range-robot/perimeter_wire/firmware/dfp/Readme.md

This folder contains device family packs (DFP)
Downloaded from: http://packs.download.atmel.com/

See https://www.microchip.com/mplab/avr-support/avr-and-arm-toolchains-c-compilers for how to use DFP
