range-robot/perimeter_wire/firmware/sensor/Readme.md

# Perimeter wire sensor firmware

## ADC

* Max Freq: 2100MHz
* Periperial Freq: 24.005MHz
* Div: 128
* Freq: 187.539kHz
* Clocks per Sample: 7
* Sampling rate: 26791Hz

* Max Freq: 2100MHz
* Periperial Freq: 24.005MHz
* Div: 16
* Freq: 1500.3kHz
* Clocks per Sample: 7
* Sampling rate: 214330Hz
