range-robot/perimeter_wire/pcb/sensor/ltspice/ti.png

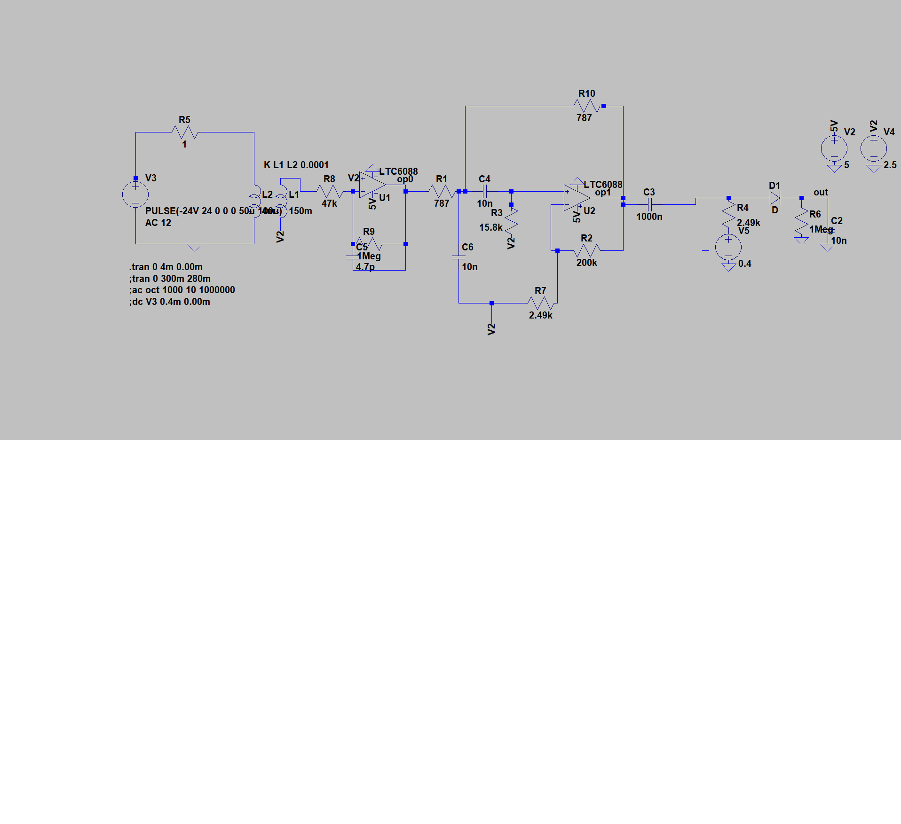
pcb/sensor/ltspice/ti.png
