range-robot/perimeter_wire/driver/generator/CHANGELOG.rst

^^^^^^^^^^^^^^^^^^^^^^^^^^^^^^^^^^^^^^^^^^^^^^^^^^^^^
Changelog for package perimeter_wire_generator_driver
^^^^^^^^^^^^^^^^^^^^^^^^^^^^^^^^^^^^^^^^^^^^^^^^^^^^^

0.0.3 (2020-06-30)
------------------

0.0.2 (2020-05-10)
------------------

0.0.1 (2020-04-14)
------------------
* Initial generator driver
* Contributors: Michael Stoll
