range-robot/perimeter_wire/driver/sensor/CHANGELOG.rst

^^^^^^^^^^^^^^^^^^^^^^^^^^^^^^^^^^^^^^^^^^^^^^^^^^
Changelog for package perimeter_wire_sensor_driver
^^^^^^^^^^^^^^^^^^^^^^^^^^^^^^^^^^^^^^^^^^^^^^^^^^

0.0.3 (2020-06-30)
------------------
* Log info about orientation
* Contributors: Michael Stoll

0.0.2 (2020-05-10)
------------------
* Add orientation parameter
* Add information about code weight to console
* Contributors: Michael Stoll

0.0.1 (2020-04-14)
------------------
* Initial sensor driver
* Contributors: Michael Stoll
