range-robot/perimeter_wire/firmware/sensor/CHANGELOG.rst

^^^^^^^^^^^^^^^^^^^^^^^^^^^^^^^^^^^^^^^^^^^^^^^^^^^^
Changelog for package perimeter_wire_sensor_firmware
^^^^^^^^^^^^^^^^^^^^^^^^^^^^^^^^^^^^^^^^^^^^^^^^^^^^

0.0.3 (2020-06-30)
------------------

0.0.2 (2020-05-10)
------------------
* add doc and script for testing
* Contributors: Michael Stoll

0.0.1 (2020-04-14)
------------------
* Initial sensor firmware
* Contributors: Michael Stoll
