range-robot/perimeter_wire/pcb/sensor/ltspice/pw_my.asc

C1: cap; 1p
C2: cap; 10n
C3: cap; 10n
D1: diode
L1: ind; 85m
R1: res; 82k
R2: res; 220k
R4: res; 220k
R5: res; 22k
R6: res; 1Meg
U1: LTC6088
U2: LTC6088
V1: voltage; PWL(0.049m 0 0.05m 80m 0.051m 0 0.099m 0 0.1m -80m 0.101m 0 0.149m 0 0.15m 80m 0.151m 0 0.199m 0 0.20m -80m 0.201m 0 0.249m 0 0.25m 80m 0.251m 0 0.299m 0 0.3m -80m 0.301m 0); AC 80m
V2: voltage; 5
V3: voltage; SINE(0 80mV 10000)
V4: voltage; 0.8
Named nets: in, filter, op1, 0, 5V, V2, op2, out
.tran 0 0.4m 0.00m
;tran 0 30m 0.00m
;ac oct 1000 10 100000
