range-robot/perimeter_wire/pcb/sensor/ltspice/pw_original.asc

C1: cap; 47p
C2: cap; 100n
C3: cap; 1000n
C4: cap; 47p
C5: cap; 1000n
D1: diode; 1N4148
D2: diode; 1N4148
L1: ind2; 85m
L2: ind2; 1m
R1: res; 85k
R2: res; 100k
R3: res; 10k
R4: res; 100k
R5: res; 10k
R6: res; 10Meg
R7: res; 100k
R8: res; 10
R9: res; 10Meg
R10: res; 10k
U1: LTC6088
U2: LTC6088
V1: voltage; PULSE(-24V 24V 0 0 0 1m 2m); AC 80m
V2: voltage; 5
V4: voltage; 1.5
Named nets: filter, op1, 0, 5V, V2, op2, out
.tran 0 2000m 0.00m
;.ac oct 1000 100 100000
K L1 L2 0.00001
