range-robot/perimeter_wire/pcb/sensor/ltspice/pw_ti.asc

C2: cap; 10n
C3: cap; 1000n
C4: cap; 10n
C5: cap; 4.7p
C6: cap; 10n
D1: diode
L1: ind2; 150m
L2: ind2; 4m
R1: res; 787
R2: res; 200k
R3: res; 15.8k
R4: res; 2.49k
R5: res; 1
R6: res; 1Meg
R7: res; 2.49k
R8: res; 47k
R9: res; 1Meg
R10: res; 787
U1: LTC6088
U2: LTC6088
V2: voltage; 5
V3: voltage; PULSE(-24V 24 0 0 0 50u 100u); AC 12
V4: voltage; 2.5
V5: voltage; 0.4
Named nets: op1, 0, 5V, V2, out, op0
.tran 0 4m 0.00m
;tran 0 300m 280m
;ac oct 1000 10 1000000
;dc V3 0.4m 0.00m
K L1 L2 0.0001
