range-robot/perimeter_wire/firmware/generator/driver_init.c

/*
 * Code generated from Atmel Start.
 *
 * This file will be overwritten when reconfiguring your Atmel Start project.
 * Please copy examples or other code you want to keep to a separate file
 * to avoid losing it when reconfiguring.
 */

#include "driver_init.h"
#include <peripheral_clk_config.h>
#include <utils.h>
#include <hal_init.h>
#include <hpl_gclk_base.h>
#include <hpl_pm_base.h>

#include <hpl_adc_base.h>

/* The channel amount for ADC */
#define ADC_0_CH_AMOUNT 1

/* The buffer size for ADC */
#define ADC_0_BUFFER_SIZE 16

/* The maximal channel number of enabled channels */
#define ADC_0_CH_MAX 0

struct adc_async_descriptor         ADC_0;
struct adc_async_channel_descriptor ADC_0_ch[ADC_0_CH_AMOUNT];
struct timer_descriptor             TIMER_0;

static uint8_t ADC_0_buffer[ADC_0_BUFFER_SIZE];
static uint8_t ADC_0_map[ADC_0_CH_MAX + 1];

struct flash_descriptor FLASH_INSTANCE;

/**
 * \brief ADC initialization function
 *
 * Enables ADC peripheral, clocks and initializes ADC driver
 */
void ADC_0_init(void)
{
	_pm_enable_bus_clock(PM_BUS_APBC, ADC);
	_gclk_enable_channel(ADC_GCLK_ID, CONF_GCLK_ADC_SRC);
	adc_async_init(&ADC_0, ADC, ADC_0_map, ADC_0_CH_MAX, ADC_0_CH_AMOUNT, &ADC_0_ch[0], (void *)NULL);
	adc_async_register_channel_buffer(&ADC_0, 0, ADC_0_buffer, ADC_0_BUFFER_SIZE);

	// Disable digital pin circuitry
	gpio_set_pin_direction(V_SENSE, GPIO_DIRECTION_OFF);

	gpio_set_pin_function(V_SENSE, PINMUX_PA04B_ADC_AIN4);

	// Disable digital pin circuitry
	gpio_set_pin_direction(R_TEMP, GPIO_DIRECTION_OFF);

	gpio_set_pin_function(R_TEMP, PINMUX_PA05B_ADC_AIN5);
}

void FLASH_INSTANCE_CLOCK_init(void)
{

	_pm_enable_bus_clock(PM_BUS_APBB, NVMCTRL);
}

void FLASH_INSTANCE_init(void)
{
	FLASH_INSTANCE_CLOCK_init();
	flash_init(&FLASH_INSTANCE, NVMCTRL);
}

/**
 * \brief Timer initialization function
 *
 * Enables Timer peripheral, clocks and initializes Timer driver
 */
static void TIMER_0_init(void)
{
	_pm_enable_bus_clock(PM_BUS_APBC, TC3);
	_gclk_enable_channel(TC3_GCLK_ID, CONF_GCLK_TC3_SRC);

	timer_init(&TIMER_0, TC3, _tc_get_timer());
}

void USB_DEVICE_INSTANCE_PORT_init(void)
{

	gpio_set_pin_direction(USB_DM,
	                       // <y> Pin direction
	                       // <id> pad_direction
	                       // <GPIO_DIRECTION_OFF"> Off
	                       // <GPIO_DIRECTION_IN"> In
	                       // <GPIO_DIRECTION_OUT"> Out
	                       GPIO_DIRECTION_OUT);

	gpio_set_pin_level(USB_DM,
	                   // <y> Initial level
	                   // <id> pad_initial_level
	                   // <false"> Low
	                   // <true"> High
	                   false);

	gpio_set_pin_pull_mode(USB_DM,
	                       // <y> Pull configuration
	                       // <id> pad_pull_config
	                       // <GPIO_PULL_OFF"> Off
	                       // <GPIO_PULL_UP"> Pull-up
	                       // <GPIO_PULL_DOWN"> Pull-down
	                       GPIO_PULL_OFF);

	gpio_set_pin_function(USB_DM,
	                      // <y> Pin function
	                      // <id> pad_function
	                      // <i> Auto : use driver pinmux if signal is imported by driver, else turn off function
	                      // <PINMUX_PA24G_USB_DM"> Auto
	                      // <GPIO_PIN_FUNCTION_OFF"> Off
	                      // <GPIO_PIN_FUNCTION_A"> A
	                      // <GPIO_PIN_FUNCTION_B"> B
	                      // <GPIO_PIN_FUNCTION_C"> C
	                      // <GPIO_PIN_FUNCTION_D"> D
	                      // <GPIO_PIN_FUNCTION_E"> E
	                      // <GPIO_PIN_FUNCTION_F"> F
	                      // <GPIO_PIN_FUNCTION_G"> G
	                      // <GPIO_PIN_FUNCTION_H"> H
	                      PINMUX_PA24G_USB_DM);

	gpio_set_pin_direction(USB_DP,
	                       // <y> Pin direction
	                       // <id> pad_direction
	                       // <GPIO_DIRECTION_OFF"> Off
	                       // <GPIO_DIRECTION_IN"> In
	                       // <GPIO_DIRECTION_OUT"> Out
	                       GPIO_DIRECTION_OUT);

	gpio_set_pin_level(USB_DP,
	                   // <y> Initial level
	                   // <id> pad_initial_level
	                   // <false"> Low
	                   // <true"> High
	                   false);

	gpio_set_pin_pull_mode(USB_DP,
	                       // <y> Pull configuration
	                       // <id> pad_pull_config
	                       // <GPIO_PULL_OFF"> Off
	                       // <GPIO_PULL_UP"> Pull-up
	                       // <GPIO_PULL_DOWN"> Pull-down
	                       GPIO_PULL_OFF);

	gpio_set_pin_function(USB_DP,
	                      // <y> Pin function
	                      // <id> pad_function
	                      // <i> Auto : use driver pinmux if signal is imported by driver, else turn off function
	                      // <PINMUX_PA25G_USB_DP"> Auto
	                      // <GPIO_PIN_FUNCTION_OFF"> Off
	                      // <GPIO_PIN_FUNCTION_A"> A
	                      // <GPIO_PIN_FUNCTION_B"> B
	                      // <GPIO_PIN_FUNCTION_C"> C
	                      // <GPIO_PIN_FUNCTION_D"> D
	                      // <GPIO_PIN_FUNCTION_E"> E
	                      // <GPIO_PIN_FUNCTION_F"> F
	                      // <GPIO_PIN_FUNCTION_G"> G
	                      // <GPIO_PIN_FUNCTION_H"> H
	                      PINMUX_PA25G_USB_DP);
}

/* The USB module requires a GCLK_USB of 48 MHz ~ 0.25% clock
 * for low speed and full speed operation. */
#if (CONF_GCLK_USB_FREQUENCY > (48000000 + 48000000 / 400)) || (CONF_GCLK_USB_FREQUENCY < (48000000 - 48000000 / 400))
#warning USB clock should be 48MHz ~ 0.25% clock, check your configuration!
#endif

void USB_DEVICE_INSTANCE_CLOCK_init(void)
{

	_pm_enable_bus_clock(PM_BUS_APBB, USB);
	_pm_enable_bus_clock(PM_BUS_AHB, USB);
	_gclk_enable_channel(USB_GCLK_ID, CONF_GCLK_USB_SRC);
}

void USB_DEVICE_INSTANCE_init(void)
{
	USB_DEVICE_INSTANCE_CLOCK_init();
	usb_d_init();
	USB_DEVICE_INSTANCE_PORT_init();
}

void system_init(void)
{
	init_mcu();

	// GPIO on PA00

	gpio_set_pin_level(EN_B,
	                   // <y> Initial level
	                   // <id> pad_initial_level
	                   // <false"> Low
	                   // <true"> High
	                   false);

	// Set pin direction to output
	gpio_set_pin_direction(EN_B, GPIO_DIRECTION_OUT);

	gpio_set_pin_function(EN_B, GPIO_PIN_FUNCTION_OFF);

	// GPIO on PA01

	// Set pin direction to input
	gpio_set_pin_direction(ERROR_B, GPIO_DIRECTION_IN);

	gpio_set_pin_pull_mode(ERROR_B,
	                       // <y> Pull configuration
	                       // <id> pad_pull_config
	                       // <GPIO_PULL_OFF"> Off
	                       // <GPIO_PULL_UP"> Pull-up
	                       // <GPIO_PULL_DOWN"> Pull-down
	                       GPIO_PULL_OFF);

	gpio_set_pin_function(ERROR_B, GPIO_PIN_FUNCTION_OFF);

	// GPIO on PA02

	gpio_set_pin_level(IN1_B,
	                   // <y> Initial level
	                   // <id> pad_initial_level
	                   // <false"> Low
	                   // <true"> High
	                   false);

	// Set pin direction to output
	gpio_set_pin_direction(IN1_B, GPIO_DIRECTION_OUT);

	gpio_set_pin_function(IN1_B, GPIO_PIN_FUNCTION_OFF);

	// GPIO on PA03

	gpio_set_pin_level(IN2_B,
	                   // <y> Initial level
	                   // <id> pad_initial_level
	                   // <false"> Low
	                   // <true"> High
	                   false);

	// Set pin direction to output
	gpio_set_pin_direction(IN2_B, GPIO_DIRECTION_OUT);

	gpio_set_pin_function(IN2_B, GPIO_PIN_FUNCTION_OFF);

	// GPIO on PA06

	gpio_set_pin_level(IN1_A,
	                   // <y> Initial level
	                   // <id> pad_initial_level
	                   // <false"> Low
	                   // <true"> High
	                   false);

	// Set pin direction to output
	gpio_set_pin_direction(IN1_A, GPIO_DIRECTION_OUT);

	gpio_set_pin_function(IN1_A, GPIO_PIN_FUNCTION_OFF);

	// GPIO on PA07

	gpio_set_pin_level(IN2_A,
	                   // <y> Initial level
	                   // <id> pad_initial_level
	                   // <false"> Low
	                   // <true"> High
	                   false);

	// Set pin direction to output
	gpio_set_pin_direction(IN2_A, GPIO_DIRECTION_OUT);

	gpio_set_pin_function(IN2_A, GPIO_PIN_FUNCTION_OFF);

	// GPIO on PA08

	gpio_set_pin_level(EN_A,
	                   // <y> Initial level
	                   // <id> pad_initial_level
	                   // <false"> Low
	                   // <true"> High
	                   false);

	// Set pin direction to output
	gpio_set_pin_direction(EN_A, GPIO_DIRECTION_OUT);

	gpio_set_pin_function(EN_A, GPIO_PIN_FUNCTION_OFF);

	// GPIO on PA09

	// Set pin direction to input
	gpio_set_pin_direction(ERROR_A, GPIO_DIRECTION_IN);

	gpio_set_pin_pull_mode(ERROR_A,
	                       // <y> Pull configuration
	                       // <id> pad_pull_config
	                       // <GPIO_PULL_OFF"> Off
	                       // <GPIO_PULL_UP"> Pull-up
	                       // <GPIO_PULL_DOWN"> Pull-down
	                       GPIO_PULL_OFF);

	gpio_set_pin_function(ERROR_A, GPIO_PIN_FUNCTION_OFF);

	// GPIO on PA16

	gpio_set_pin_level(LED2_B,
	                   // <y> Initial level
	                   // <id> pad_initial_level
	                   // <false"> Low
	                   // <true"> High
	                   true);

	// Set pin direction to output
	gpio_set_pin_direction(LED2_B, GPIO_DIRECTION_OUT);

	gpio_set_pin_function(LED2_B, GPIO_PIN_FUNCTION_OFF);

	// GPIO on PA17

	gpio_set_pin_level(LED2_G,
	                   // <y> Initial level
	                   // <id> pad_initial_level
	                   // <false"> Low
	                   // <true"> High
	                   true);

	// Set pin direction to output
	gpio_set_pin_direction(LED2_G, GPIO_DIRECTION_OUT);

	gpio_set_pin_function(LED2_G, GPIO_PIN_FUNCTION_OFF);

	// GPIO on PA18

	gpio_set_pin_level(LED2_R,
	                   // <y> Initial level
	                   // <id> pad_initial_level
	                   // <false"> Low
	                   // <true"> High
	                   true);

	// Set pin direction to output
	gpio_set_pin_direction(LED2_R, GPIO_DIRECTION_OUT);

	gpio_set_pin_function(LED2_R, GPIO_PIN_FUNCTION_OFF);

	// GPIO on PA19

	gpio_set_pin_level(LED1_B,
	                   // <y> Initial level
	                   // <id> pad_initial_level
	                   // <false"> Low
	                   // <true"> High
	                   true);

	// Set pin direction to output
	gpio_set_pin_direction(LED1_B, GPIO_DIRECTION_OUT);

	gpio_set_pin_function(LED1_B, GPIO_PIN_FUNCTION_OFF);

	// GPIO on PA22

	gpio_set_pin_level(LED1_G,
	                   // <y> Initial level
	                   // <id> pad_initial_level
	                   // <false"> Low
	                   // <true"> High
	                   true);

	// Set pin direction to output
	gpio_set_pin_direction(LED1_G, GPIO_DIRECTION_OUT);

	gpio_set_pin_function(LED1_G, GPIO_PIN_FUNCTION_OFF);

	// GPIO on PA23

	gpio_set_pin_level(LED1_R,
	                   // <y> Initial level
	                   // <id> pad_initial_level
	                   // <false"> Low
	                   // <true"> High
	                   true);

	// Set pin direction to output
	gpio_set_pin_direction(LED1_R, GPIO_DIRECTION_OUT);

	gpio_set_pin_function(LED1_R, GPIO_PIN_FUNCTION_OFF);

	ADC_0_init();

	FLASH_INSTANCE_init();

	TIMER_0_init();

	USB_DEVICE_INSTANCE_init();
}
