range-robot/perimeter_wire/driver/generator/src/driver.cpp

#include <string>
#include <perimeter_wire_generator_driver/driver.h>
#include <perimeter_wire_generator_firmware/registers.h>
#include "async_serial.h"
#include "data_link_layer.h"
#include "app_layer.h"
#include "console.h"


#define FIRMWARE_VERSION 2

#define ADC_RESOLUTION (1.65 / 256)
#define VOLTAGE_DIVIDER_FACTOR ((1000 + 22) / 22)
// From MCP9700A datasheet
#define TEMP_COEFFICENT (0.01)
#define TEMP_ZERO_VOLTAGE (0.5)
using namespace perimeter_wire_generator;

GeneratorDriver::GeneratorDriver(const std::string& com_port)
{
  using namespace std::placeholders;
  serial_ = std::make_shared<AsyncSerial>(com_port);
  dll_ = std::make_shared<DataLink>(serial_);
  app_ = std::make_shared<AppLayer>(dll_);
  app_->setHelloCallback(std::bind(&GeneratorDriver::helloCallback, this, _1));
  app_->setCommandResultCallback(std::bind(&GeneratorDriver::cmdResultCallback, this, _1, _2));
}

GeneratorDriver::~GeneratorDriver()
{
  serial_->runOnce();
  serial_->stop();
}

void GeneratorDriver::helloCallback(uint16_t version)
{
  if (version != FIRMWARE_VERSION)
  {
    ROS_ERROR("Firmware version incompatible. Excpected: %i, Got: %i", FIRMWARE_VERSION, (int)version);
  }
}

void GeneratorDriver::cmdResultCallback(uint8_t cmd, uint8_t result)
{
  ROS_ERROR("Received orphanded command result. Cmd: %i, Result: %x", (int)cmd, (int)result);
}

void GeneratorDriver::run()
{
  serial_->run();
}

void GeneratorDriver::runOnce()
{
  serial_->runOnce();
}

void GeneratorDriver::stop()
{
  serial_->stop();
}

bool GeneratorDriver::getFWVersion(uint16_t& version)
{
  return app_->getVersion(version);
}

void GeneratorDriver::reset() {
  app_->reset();
}

bool GeneratorDriver::setControl(bool enabled)
{
  uint8_t control = enabled ? 0x01 : 0x00;
  app_->setReg(REGISTER_CONTROL, control);
  return true;
}

bool GeneratorDriver::saveConfiguration()
{
  uint8_t control;
  if (!app_->getReg(REGISTER_CONTROL, control))
    return false;
  app_->setReg(REGISTER_CONTROL, control | 0x80);
  return true;
}

bool GeneratorDriver::getVoltage(float& voltage)
{
  uint8_t int_volt;
  if (!app_->getReg(REGISTER_VOLTAGE, int_volt))
    return false;
  voltage = int_volt * ADC_RESOLUTION * VOLTAGE_DIVIDER_FACTOR;
  return true;
}

bool GeneratorDriver::getTemperature(float& temp)
{
  uint8_t int_temp;
  if (!app_->getReg(REGISTER_TEMP, int_temp))
    return false;
  float temp_volt = int_temp * ADC_RESOLUTION;
  temp = (temp_volt - TEMP_ZERO_VOLTAGE) / TEMP_COEFFICENT;
  return true;
}

bool GeneratorDriver::getChannelAMode(uint8_t& mode)
{
  return app_->getReg(REGISTER_A_MODE, mode);
}

bool GeneratorDriver::setChannelAMode(uint8_t mode)
{
  app_->setReg(REGISTER_A_MODE, mode);
  return true;
}

bool GeneratorDriver::getChannelBMode(uint8_t& mode)
{
  return app_->getReg(REGISTER_B_MODE, mode);
}

bool GeneratorDriver::setChannelBMode(uint8_t mode)
{
  app_->setReg(REGISTER_B_MODE, mode);
  return true;
}

bool GeneratorDriver::getChannelADivider(uint8_t& divider)
{
  return app_->getReg(REGISTER_A_DIV, divider);
}

bool GeneratorDriver::setChannelADivider(uint8_t divider)
{
  app_->setReg(REGISTER_A_DIV, divider);
  return true;
}

bool GeneratorDriver::getChannelBDivider(uint8_t& divider)
{
  return app_->getReg(REGISTER_B_DIV, divider);
}

bool GeneratorDriver::setChannelBDivider(uint8_t divider)
{
  app_->setReg(REGISTER_B_DIV, divider);
  return true;
}

bool GeneratorDriver::getChannelACode(uint16_t& code)
{
  return app_->getReg16(REGISTER_A_CODE, code);
}

bool GeneratorDriver::setChannelACode(uint16_t code)
{
  app_->setReg16(REGISTER_A_CODE, code);
  return true;
}

bool GeneratorDriver::getChannelBCode(uint16_t& code)
{
  return app_->getReg16(REGISTER_B_CODE, code);
}

bool GeneratorDriver::setChannelBCode(uint16_t code)
{
  app_->setReg16(REGISTER_B_CODE, code);
  return true;
}
