range-robot/perimeter_wire/firmware/generator/driver/perimeter_wire_generator.h

#ifndef PERIMETER_WIRE_GENERATOR_H_
#define PERIMETER_WIRE_GENERATOR_H_

#include <hal_timer.h>
#include "atmel_start_pins.h"
#include "board.h"
#include "leds.h"

/* CONFIG */
#define PGWEN_TIMER_FREQUENCY TIMER_FREQUENCY
#define PWGEN_ENABLE_A EN_A
#define PWGEN_IN1_A IN1_A
#define PWGEN_IN2_A IN2_A
#define PWGEN_ERROR_A ERROR_A
#define PWGEN_ENABLE_B EN_B
#define PWGEN_IN1_B IN1_B
#define PWGEN_IN2_B IN2_B
#define PWGEN_ERROR_B ERROR_B
/* END CONFIG */

enum pwgen_mode_t {
	PWGEN_MODE_DISABLED = 0,
	PWGEN_MODE_ENABLED = 0x01,
	PWGEN_MODE_H = 0x2,
	PWGEN_MODE_CODE = 0x4
};

enum pwgen_channel_t {
	PWGEN_A,
	PWGEN_B
};

struct pwgen_t {
	enum pwgen_channel_t channel;
	LedMode* led;

	// pins
	uint32_t enable;
	uint32_t in1, in2;
	uint32_t error;
	
	// state
	enum {
		_PWGEN_STATE_IDLE,
		_PWGEN_STATE_RUN
	} state;
	enum pwgen_mode_t mode;
	struct timer_task task;
	uint8_t pos;	// position in code or true/false if no code
	uint16_t code;
};

struct pwgen_config_t
{
	enum pwgen_mode_t mode;
	uint8_t divider;
	uint16_t code;
};

void pwgen_init(struct pwgen_t* const gen, enum pwgen_channel_t channel);
void pwgen_disable(struct pwgen_t* const gen, struct timer_descriptor* const timer);
void pwgen_set_config(struct pwgen_t* const gen, const struct pwgen_config_t* const config, struct timer_descriptor* const timer);
void pwgen_task(bool set_led);

#endif /* PERIMETER_WIRE_GENERATOR_H_ */
