range-robot/perimeter_wire/firmware/bootloader/src/main.c

/*
  Copyright (c) 2015 Arduino LLC.  All right reserved.
  Copyright (c) 2015 Atmel Corporation/Thibaut VIARD.  All right reserved.

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
  You should have received a copy of the GNU Lesser General Public
  License along with this library; if not, write to the Free Software
  Foundation, Inc., 51 Franklin St, Fifth Floor, Boston, MA  02110-1301  USA
*/

#include <stdio.h>
#include <sam.h>
#include "sam_ba_monitor.h"
#include "sam_ba_serial.h"
#include "board_definitions.h"
#include "board_driver_led.h"
#include "board_driver_i2c.h"
#include "board_driver_pmic.h"
#include "sam_ba_usb.h"
#include "sam_ba_cdc.h"

extern uint32_t __sketch_vectors_ptr; // Exported value from linker script
extern void board_init(void);

volatile uint32_t* pulSketch_Start_Address;

static void jump_to_application(void) {
	if (__sketch_vectors_ptr == 0)
		return;
  /* Rebase the Stack Pointer */
  __set_MSP( (uint32_t)(__sketch_vectors_ptr) );

  /* Rebase the vector table base address */
  SCB->VTOR = ((uint32_t)(&__sketch_vectors_ptr) & SCB_VTOR_TBLOFF_Msk);

  /* Jump to application Reset Handler in the application */
  asm("bx %0"::"r"(*pulSketch_Start_Address));
}

static volatile bool main_b_cdc_enable = false;

#ifdef CONFIGURE_PMIC
static volatile bool jump_to_app = false;
#endif
#ifdef SAM_BA_TIMEOUT
static volatile int timeout = SAM_BA_TIMEOUT;
#endif

/**
 * \brief Check the application startup condition
 *
 */
static bool has_start_application(void)
{
//  LED_init();
//  LED_off();

  /*
   * Test sketch stack pointer @ &__sketch_vectors_ptr
   * Stay in SAM-BA if value @ (&__sketch_vectors_ptr) == 0xFFFFFFFF (Erased flash cell value)
   */
  if (__sketch_vectors_ptr == 0xFFFFFFFFu)
  {
    /* Stay in bootloader */
    return false;
  }

  /*
   * Load the sketch Reset Handler address
   * __sketch_vectors_ptr is exported from linker script and point on first 32b word of sketch vector table
   * First 32b word is sketch stack
   * Second 32b word is sketch entry point: Reset_Handler()
   */
  pulSketch_Start_Address = &__sketch_vectors_ptr ;
  pulSketch_Start_Address++ ;

  /*
   * Test vector table address of sketch @ &__sketch_vectors_ptr
   * Stay in SAM-BA if this function is not aligned enough, ie not valid
   */
  if ( ((uint32_t)(&__sketch_vectors_ptr) & ~SCB_VTOR_TBLOFF_Msk) != 0x00)
  {
    /* Stay in bootloader */
    return false;
  }


/*
#if defined(BOOT_LOAD_PIN)
  volatile PortGroup *boot_port = (volatile PortGroup *)(&(PORT->Group[BOOT_LOAD_PIN / 32]));
  volatile bool boot_en;

  // Enable the input mode in Boot GPIO Pin
  boot_port->DIRCLR.reg = BOOT_PIN_MASK;
  boot_port->PINCFG[BOOT_LOAD_PIN & 0x1F].reg = PORT_PINCFG_INEN | PORT_PINCFG_PULLEN;
  boot_port->OUTSET.reg = BOOT_PIN_MASK;
  // Read the BOOT_LOAD_PIN status
  boot_en = (boot_port->IN.reg) & BOOT_PIN_MASK;

  // Check the bootloader enable condition
  if (!boot_en)
  {
    // Stay in bootloader
    return false;
  }
#endif
*/
	return true;
}

#if DEBUG_ENABLE
#	define DEBUG_PIN_HIGH 	port_pin_set_output_level(BOOT_LED, 1)
#	define DEBUG_PIN_LOW 	port_pin_set_output_level(BOOT_LED, 0)
#else
#	define DEBUG_PIN_HIGH 	do{}while(0)
#	define DEBUG_PIN_LOW 	do{}while(0)
#endif

/**
 *  \brief SAMD21 SAM-BA Main loop.
 *  \return Unused (ANSI-C compatibility).
 */
int main(void)
{
#if defined(SAM_BA_USBCDC_ONLY)  ||  defined(SAM_BA_BOTH_INTERFACES)
  P_USB_CDC pCdc;
#endif
  DEBUG_PIN_HIGH;

  /* Jump in application if condition is satisfied */
  bool has_app = has_start_application();

#ifndef SAM_BA_TIMEOUT
  if (has_app)
  {  
	  //  LED_on();
#ifdef CONFIGURE_PMIC
	jump_to_app = true;
#else
	jump_to_application();
#endif
  }
#else
  timeout = has_app ? SAM_BA_TIMEOUT : -1;
#endif


  /* We have determined we should stay in the monitor. */
  /* System initialization */
  board_init();
  __enable_irq();

#ifdef CONFIGURE_PMIC
  configure_pmic();
#endif

#ifdef CONFIGURE_PMIC
  if (jump_to_app == true) {
    jump_to_application();
  }
#endif

#if defined(SAM_BA_UART_ONLY)  ||  defined(SAM_BA_BOTH_INTERFACES)
  /* UART is enabled in all cases */
  serial_open();
#endif

#if defined(SAM_BA_USBCDC_ONLY)  ||  defined(SAM_BA_BOTH_INTERFACES)
  pCdc = usb_init();
#endif

  DEBUG_PIN_LOW;

  /* Initialize LEDs */
  LED_init();
  LEDRX_init();
  LEDRX_off();
  LEDTX_init();
  LEDTX_off();

  /* Start the sys tick (1 ms) */
  SysTick_Config(48000);

  /* Wait for a complete enum on usb or a '#' char on serial line */
  while (1)
  {
#if defined(SAM_BA_USBCDC_ONLY)  ||  defined(SAM_BA_BOTH_INTERFACES)
    if (pCdc->IsConfigured(pCdc) != 0)
    {
      main_b_cdc_enable = true;
    }

    /* Check if a USB enumeration has succeeded and if comm port has been opened */
    if (main_b_cdc_enable)
    {
      sam_ba_monitor_init(SAM_BA_INTERFACE_USBCDC);
      /* SAM-BA on USB loop */
      while( 1 )
      {
        sam_ba_monitor_run();
      }
    }
#endif

#if defined(SAM_BA_UART_ONLY)  ||  defined(SAM_BA_BOTH_INTERFACES)
    /* Check if a '#' has been received */
    if (!main_b_cdc_enable && serial_sharp_received())
    {
      sam_ba_monitor_init(SAM_BA_INTERFACE_USART);
      /* SAM-BA on Serial loop */
      while(1)
      {
        sam_ba_monitor_run();
      }
    }
#endif
  }
}

void SysTick_Handler(void)
{
#ifdef SAM_BA_TIMEOUT
  // timeout == -1 => disabled
  if (timeout > 0)
	timeout --;
  else if (timeout == 0)
    jump_to_application();
#endif

  LED_pulse();

  sam_ba_monitor_sys_tick();
}
