range-robot/perimeter_wire/firmware/generator/examples/driver_examples.c

/*
 * Code generated from Atmel Start.
 *
 * This file will be overwritten when reconfiguring your Atmel Start project.
 * Please copy examples or other code you want to keep to a separate file
 * to avoid losing it when reconfiguring.
 */

#include "driver_examples.h"
#include "driver_init.h"
#include "utils.h"

static void convert_cb_ADC_0(const struct adc_async_descriptor *const descr, const uint8_t channel)
{
}

/**
 * Example of using ADC_0 to generate waveform.
 */
void ADC_0_example(void)
{
	adc_async_register_callback(&ADC_0, 0, ADC_ASYNC_CONVERT_CB, convert_cb_ADC_0);
	adc_async_enable_channel(&ADC_0, 0);
	adc_async_start_conversion(&ADC_0);
}

static uint8_t src_data[128];
static uint8_t chk_data[128];
/**
 * Example of using FLASH_INSTANCE to read and write Flash main array.
 */
void FLASH_INSTANCE_example(void)
{
	uint32_t page_size;
	uint16_t i;

	/* Init source data */
	page_size = flash_get_page_size(&FLASH_INSTANCE);

	for (i = 0; i < page_size; i++) {
		src_data[i] = i;
	}

	/* Write data to flash */
	flash_write(&FLASH_INSTANCE, 0x3200, src_data, page_size);

	/* Read data from flash */
	flash_read(&FLASH_INSTANCE, 0x3200, chk_data, page_size);
}

/**
 * Example of using FLASH_INSTANCE to read and write Flash RWWEE array.
 */
void RWW_FLASH_INSTANCE_example(void)
{
	uint32_t page_size;
	uint16_t i;

	/* Init source data */
	page_size = _rww_flash_get_page_size(&FLASH_INSTANCE.dev);

	for (i = 0; i < page_size; i++) {
		src_data[i] = i;
	}

	/* Write data to RWWEE flash */
	if (_rww_flash_write(&FLASH_INSTANCE.dev, NVMCTRL_RWW_EEPROM_ADDR, src_data, page_size) != ERR_NONE) {
		while (1)
			; /* Trap here when flash write error happen */
	}

	/* Read data from RWWEE flash */
	if (_rww_flash_read(&FLASH_INSTANCE.dev, NVMCTRL_RWW_EEPROM_ADDR, chk_data, page_size) != ERR_NONE) {
		while (1)
			; /* Trap here when flash read error happen */
	}

	/* Check data */
	for (i = 0; i < page_size; i++) {
		if (src_data[i] != chk_data[i]) {
			while (1)
				; /* Trap here when check error happen */
		}
	}
}

static struct timer_task TIMER_0_task1, TIMER_0_task2;

/**
 * Example of using TIMER_0.
 */
static void TIMER_0_task1_cb(const struct timer_task *const timer_task)
{
}

static void TIMER_0_task2_cb(const struct timer_task *const timer_task)
{
}

void TIMER_0_example(void)
{
	TIMER_0_task1.interval = 100;
	TIMER_0_task1.cb       = TIMER_0_task1_cb;
	TIMER_0_task1.mode     = TIMER_TASK_REPEAT;
	TIMER_0_task2.interval = 200;
	TIMER_0_task2.cb       = TIMER_0_task2_cb;
	TIMER_0_task2.mode     = TIMER_TASK_REPEAT;

	timer_add_task(&TIMER_0, &TIMER_0_task1);
	timer_add_task(&TIMER_0, &TIMER_0_task2);
	timer_start(&TIMER_0);
}
