range-robot/perimeter_wire/(commit log)

2019-05-17 Initial perimeter wire firmware and driver
2019-05-20 Add pcb
    [generator.sch, pspice.sch, sensor.kicad_pcb, sensor.sch]
2019-05-28 Fix lib in generator schematic
    [generator.sch]
2019-05-28 Sensor pcb complete
    [sensor.kicad_pcb, sensor.sch]
2019-09-18 Replace ferrite beads with smd types
    [sensor.kicad_pcb, sensor.sch]
2019-09-18 Use GNDA for ground layer Cleanup silk and fab
    [sensor.kicad_pcb, sensor.sch]
2019-09-18 Add generator pcb
    [generator.kicad_pcb, generator.sch]
2019-09-18 Release preparation
    [generator.kicad_pcb, generator.sch, sensor.kicad_pcb, sensor.sch]
2019-11-20 Sensor spice simulation kicad simulation does not work with opamp multiple ltspice simulations pw_original (RobotShop version) pw_my (My version) pw_ti (My version with sally key bandpass) <= Use thi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
    [pspice.sch]
2019-11-20 Add generator firmware (initial) Missing features - LEDs
    [generator.ods]
2019-11-20 Add generator driver
2019-11-20 Implement reading the temperature
2019-11-20 Cleanup sensor driver, add preliminary sensor firmware
2019-11-20 Change sensor device to samd11 Integrate correlation filter
2019-11-20 Change generator device to SAMD11 Add leds
2019-11-20 Calculate timer frequency
2019-11-20 Generator with divider configuration
    [generator.ods]
2019-11-20 Sensor firmware (no XOSC32, because it's not oscillating)
    [atmel_start_pins.h, console.cpp, driver.cpp, driver_init.c]
2019-11-20 Fix resistor value (787->787k)
    [sensor.sch]
2019-11-20 sensor driver: Fix timing
    [console.cpp, driver.cpp, node.cpp, perimeter_wire_ros.h]
2019-11-20 Implement codes and signed magnitude
    [generator.ods]
2019-11-20 Fix firmware include path
    [app_layer_config.h, com_config.h, driver.cpp]
2020-01-18 sensor driver: Check control register
2020-01-18 sensor driver: debug log: print each char
2020-01-18 sensor firmware: use external oscillator
2020-01-18 sensor firmware: react on register change selectively
2020-01-22 Replace mcu, add hall sensors, replace tht components
    [sensor.kicad_pcb, sensor.sch]
2020-01-22 Prepare next pcb
    [sensor.kicad_pcb]
2020-01-22 Change op type to SOIC
    [sensor.kicad_pcb, sensor.sch]
2020-01-22 Place and route smaller pcb
    [sensor.kicad_pcb, sensor.sch]
2020-01-22 sensor R2
    [sensor.kicad_pcb, sensor.sch]
2020-01-22 generator: pcb for modulbox
    [generator.kicad_pcb, generator.sch]
2020-01-22 Add housing / fix partnumbers
    [sensor.sch]
2020-01-22 Replace 4u7 cap on V_GND with 100n (voltage reference can't drive more than 1u) Refs C19 C20 swapped
    [sensor.kicad_pcb, sensor.sch]
2020-01-22 Add device packs and cmake for arm
2020-01-22 Update firmware for pcb r2
2020-01-22 gernerator pcb r2 - place references - adjust mask clearance
    [generator.kicad_pcb, generator.sch]
2020-01-22 generator: Update parnumbers (for r2)
    [generator.sch]
2020-02-26 generator firmware: update for pcb r2
2020-02-26 generator driver: implement voltage and temperature
2020-02-26 generator firmware: implement temperature off
2020-02-26 Replace ATSAMD21E17A with ATSAMD21E17D
    [sensor.sch]
2020-02-26 generator pcb: replace SMBJ48CA with SMBJ48A
    [generator.sch]
2020-03-03 Import bootloader from https://github.com/arduino/ArduinoCore-samd (zero bootloader) Modified to support SAMD21E17D
2020-03-03 bootloader: add timeout, fix app detection
    [board_definitions.h, main.c]
2020-03-03 sensor firmware: Make firmware bootloader compatible
2020-04-03 generator: add code metrics
    [generator.ods]
2020-04-03 sensor: implement direct buffer access
2020-04-03 sensor: use 12-bit and diffential mode adc
2020-04-03 implement reset to bootloader
    [app_layer.h, app_layer_config.h, console.cpp, data_link_layer_config.h, driver.cpp]
2020-04-03 sensor firmware: Run cpu at 48MHz
2020-04-03 firmware: Synchronize generation and sampling rate
    [generator.ods]
2020-04-03 sensor firmware: enable inputscan
2020-04-03 sensor: read all channels at once, add sync mode
    [generator.ods]
2020-04-03 Add numieric simulation
    [noise.ods]
2020-04-06 sensor: add filter and measurement count, speed up
    [noise.ods]
2020-04-06 sensor firmware: fix usb_serial
2020-04-06 sensor firmware: add error handler
    [async_serial.h, console.cpp, driver.cpp, node.cpp]
2020-04-06 sensor driver: improve output, disable on start
2020-04-06 sensor firmware: add timer for adc reset
    [driver_init.c, driver_init.h, perimeter_wire_sensor.c]
2020-04-06 sensor driver: normalize output to 0..1
2020-04-21 generator driver: fix dependencies
2020-05-10 sensor driver: Add information about code weight to console
2020-05-10 sensor driver: add orientation parameter
2020-06-25 driver: log info about orientation
2020-06-25 prod: add sensor_test.launch
